ctjhahn/BARK/README.md

# BARK
A Dog Door which implements Ultrasonic Rangefinding, RFID Scanning, and Bluetooth input for the most secure and easy to use door any pet owner could ask for.
