ctjhahn/BARK/CAD Files/Assembly_Dog_Door.SLDASM

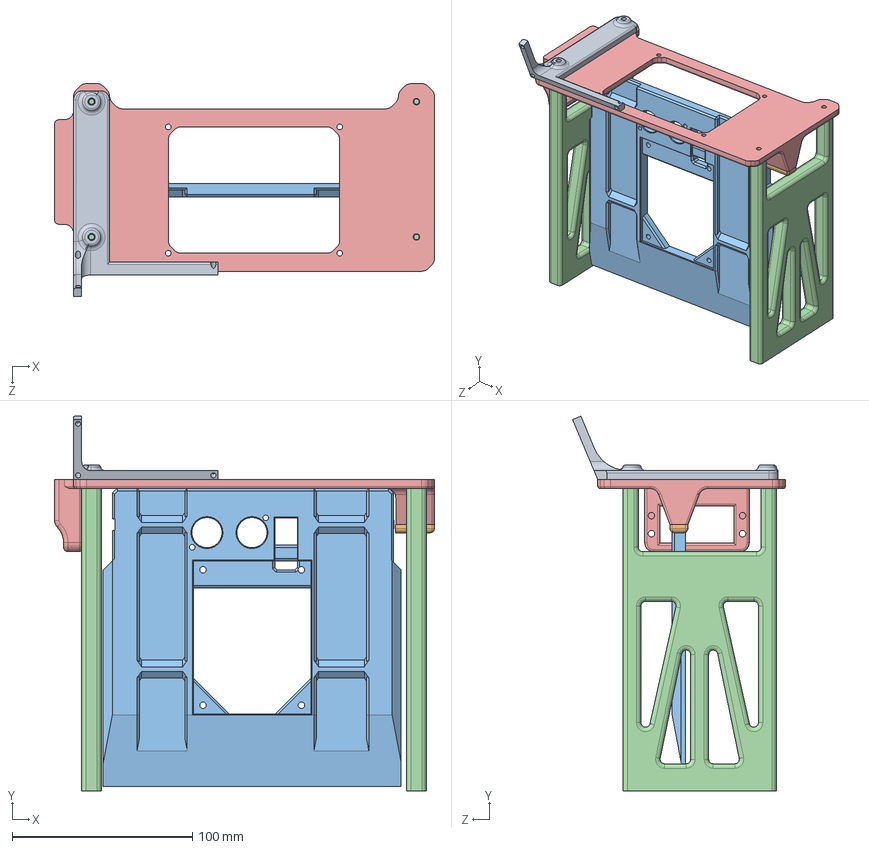
[picture p5: CAD file, 2025-03-18]
CAD Files/Assembly_Dog_Door.SLDASM
210.6 x 207.6 x 117.9 mm
Ceiling Part
Ceiling_Connecting_Brace x 2
Dog_Door_2
Pinch_Clamp
LCD Plate
