ctjhahn/BARK/CAD Files/LCD Plate.SLDPRT

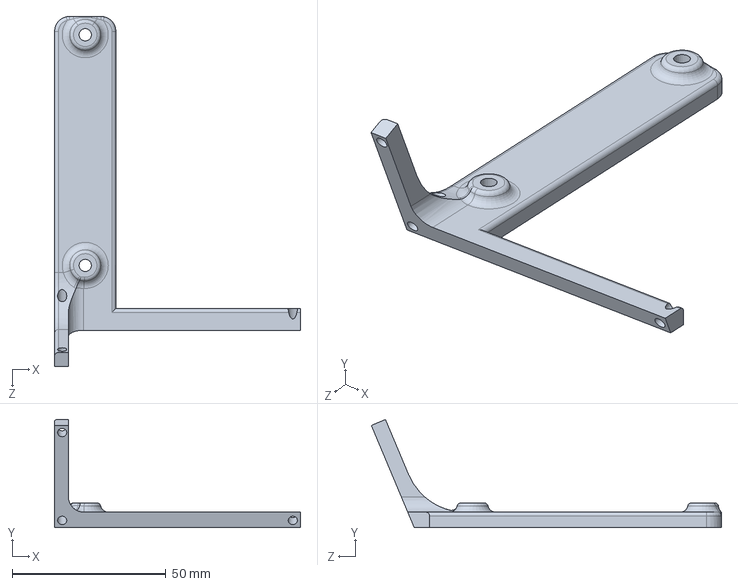
[picture p6: CAD file, 2025-03-18]
CAD Files/LCD Plate.SLDPRT
80.0 x 35.1 x 113.9 mm
