ctjhahn/BARK/CAD Files/Ceiling Part.SLDPRT

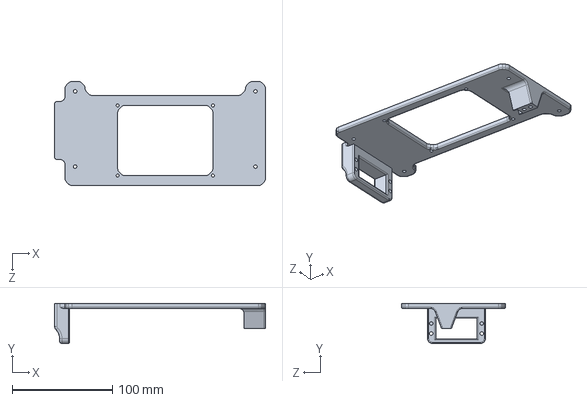
[picture p7: CAD file, 2025-03-18]
CAD Files/Ceiling Part.SLDPRT
210.6 x 40.0 x 104.0 mm
