ctjhahn/BARK/CAD Files/Dog_Door_2.SLDPRT

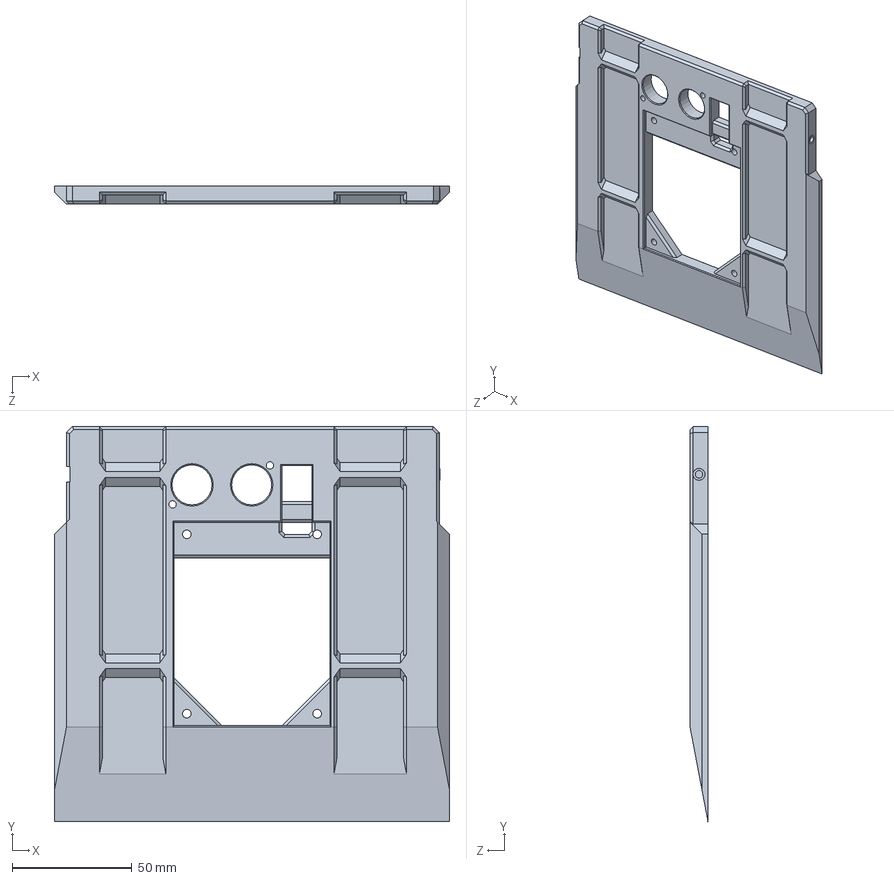
[picture p8: CAD file, 2025-03-18]
CAD Files/Dog_Door_2.SLDPRT
165.1 x 165.1 x 7.50 mm
