ctjhahn/BARK/CAD Files/Ceiling_Connecting_Brace.SLDPRT

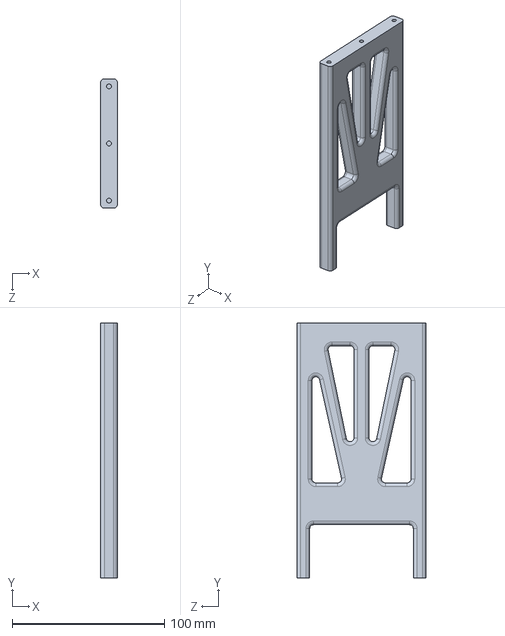
[picture p9: CAD file, 2025-03-18]
CAD Files/Ceiling_Connecting_Brace.SLDPRT
11.0 x 167.5 x 85.0 mm
