ctjhahn/BARK/CAD Files/Feet.SLDPRT

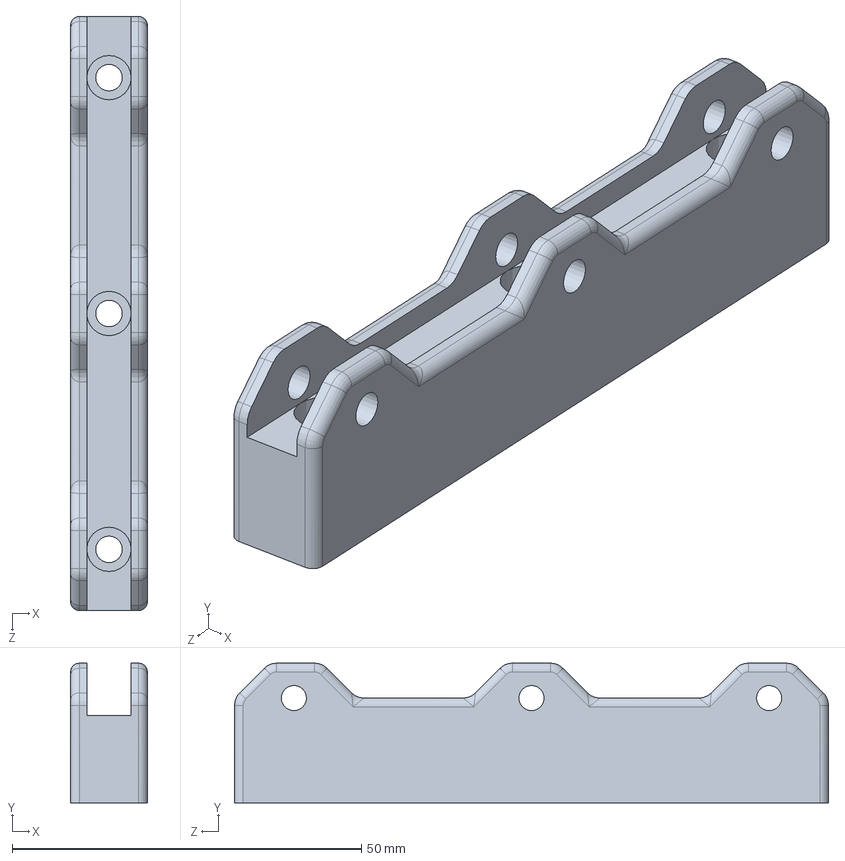
[picture p10: CAD file, 2025-03-18]
CAD Files/Feet.SLDPRT
11.0 x 20.0 x 85.0 mm
