ctjhahn/BARK/CAD Files/Pinch_Clamp.SLDPRT

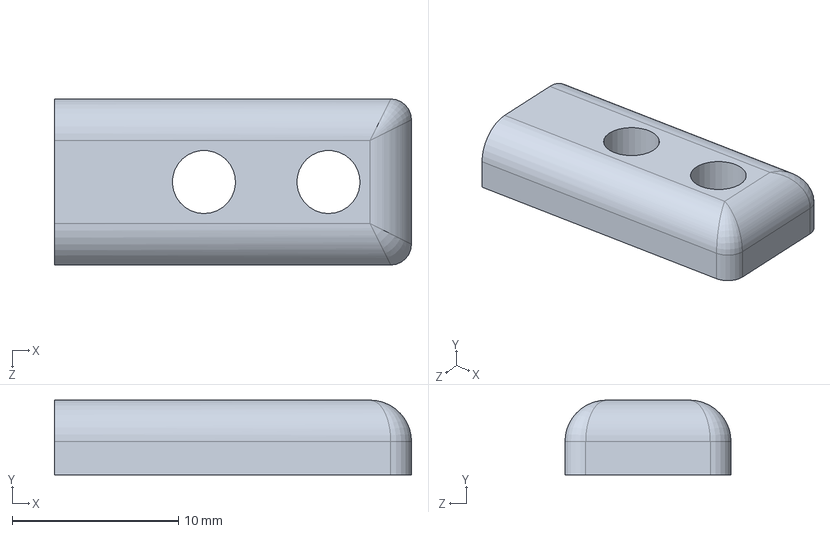
[picture p11: CAD file, 2025-03-18]
CAD Files/Pinch_Clamp.SLDPRT
21.5 x 4.50 x 10.0 mm
