ctjhahn/BARK/(list of files, cad)

Other CAD files:
CAD Files/Ceiling Part.STL
CAD Files/Dog_Door_2.STL
CAD Files/Pinch_Clamp.STL
